umbomnick/SoC-Transceptor-SpaceFibre/docs/esquematico-rtl-8b-10b.png

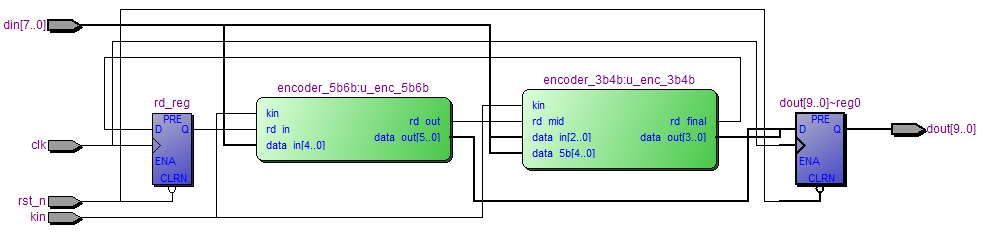
docs/esquematico-rtl-8b-10b.png
