umbomnick/SoC-Transceptor-SpaceFibre/(list of files, cad)

Other CAD files:
Space-Fibre-v1/simulation/modelsim/rtl_work/tb_leitura_banco/verilog.psm
Space-Fibre-v1/simulation/qsim/work/@m@u@x4x1/verilog.psm
Space-Fibre-v1/simulation/qsim/work/@m@u@x4x1_vlg_vec_tst/verilog.psm
sims/work/banco_de_registadores_top/verilog.psm
