umbomnick/SoC-Transceptor-SpaceFibre/sims/simulation/modelsim/rtl_work/mux_16to1_8bit/_primary.vhd

library verilog;
use verilog.vl_types.all;
entity mux_16to1_8bit is
    port(
        in0             : in     vl_logic_vector(7 downto 0);
        in1             : in     vl_logic_vector(7 downto 0);
        in2             : in     vl_logic_vector(7 downto 0);
        in3             : in     vl_logic_vector(7 downto 0);
        in4             : in     vl_logic_vector(7 downto 0);
        in5             : in     vl_logic_vector(7 downto 0);
        in6             : in     vl_logic_vector(7 downto 0);
        in7             : in     vl_logic_vector(7 downto 0);
        in8             : in     vl_logic_vector(7 downto 0);
        in9             : in     vl_logic_vector(7 downto 0);
        in10            : in     vl_logic_vector(7 downto 0);
        in11            : in     vl_logic_vector(7 downto 0);
        in12            : in     vl_logic_vector(7 downto 0);
        in13            : in     vl_logic_vector(7 downto 0);
        in14            : in     vl_logic_vector(7 downto 0);
        in15            : in     vl_logic_vector(7 downto 0);
        sel             : in     vl_logic_vector(3 downto 0);
        \out\           : out    vl_logic_vector(7 downto 0)
    );
end mux_16to1_8bit;
